Justus38/Laser_galvo_arduino_diy/README.md

# Laser_galvo_arduino_diy
In this project iam using arduino or similar microcontroller to control a laser galvo. Not a stepper motor laser galvo instead a real galvo with real galvo motors
