Justus38/Laser_galvo_arduino_diy/Testing/PCB/files/+-10v dac.kicad_pcb

## KiCad design Testing/PCB/files/+-10v dac.kicad_pcb (2024-12-08)

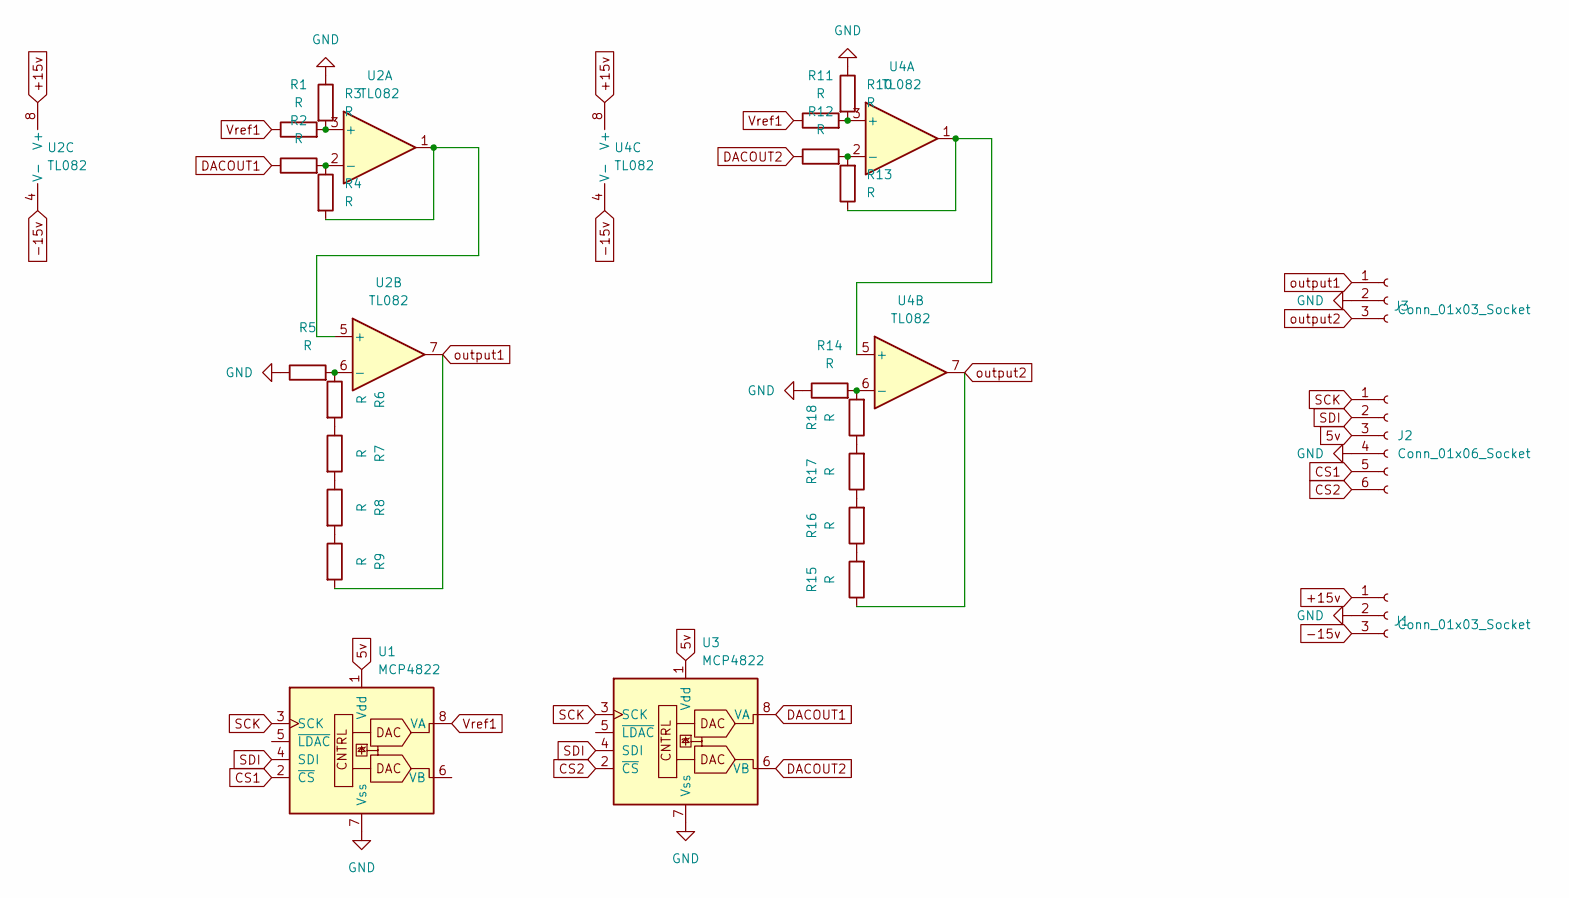
[picture p3: schematic +-10v dac.kicad_sch]

Parts:
J1, J3: Conn_01x03_Socket; PinHeader_1x03_P2.54mm_Vertical
J2: Conn_01x06_Socket; PinHeader_1x06_P2.54mm_Vertical
R1, R2, R3, R4, R5, R6, R7, R8, R9, R10, R11, R12, R13, R14, R15, R16, R17, R18: R; R_1206_3216Metric_Pad1.30x1.75mm_HandSolder
U1, U3: MCP4822; DIP-8_W7.62mm
U2: TL082
U4: TL082; DIP-8_W7.62mm

Connections:
5v: J2.3, U1.1 (Vdd), U3.1 (Vdd)
+15v: J1.1, U2.8 (V+), U4.8 (V+)
-15v: J1.3, U2.4 (V-), U4.4 (V-)
CS1: J2.5, U1.2 (~CS)
CS2: J2.6, U3.2 (~CS)
DACOUT1: R2.1, U3.8 (VA)
DACOUT2: R12.1, U3.6 (VB)
GND: J1.2, J2.4, J3.2, R3.1, R5.1, R10.1, R14.1, U1.7 (Vss), U3.7 (Vss)
unnamed: R6.2, R7.1
unnamed: R7.2, R8.1
unnamed: R8.2, R9.1
unnamed: R15.2, R16.1
unnamed: R16.2, R17.1
unnamed: R17.2, R18.1
unnamed: R1.2, R3.2, U2.3 (+)
unnamed: R2.2, R4.1, U2.2 (-)
unnamed: R4.2, U2.1, U2.5 (+)
unnamed: R5.2, R6.1, U2.6 (-)
unnamed: R10.2, R11.2, U4.3 (+)
unnamed: R12.2, R13.2, U4.2 (-)
unnamed: R13.1, U4.1, U4.5 (+)
unnamed: R14.2, R18.2, U4.6 (-)
SCK: J2.1, U1.3 (SCK), U3.3 (SCK)
SDI: J2.2, U1.4 (SDI), U3.4 (SDI)
Vref1: R1.1, R11.1, U1.8 (VA)
output1: J3.1, R9.2, U2.7
output2: J3.3, R15.1, U4.7

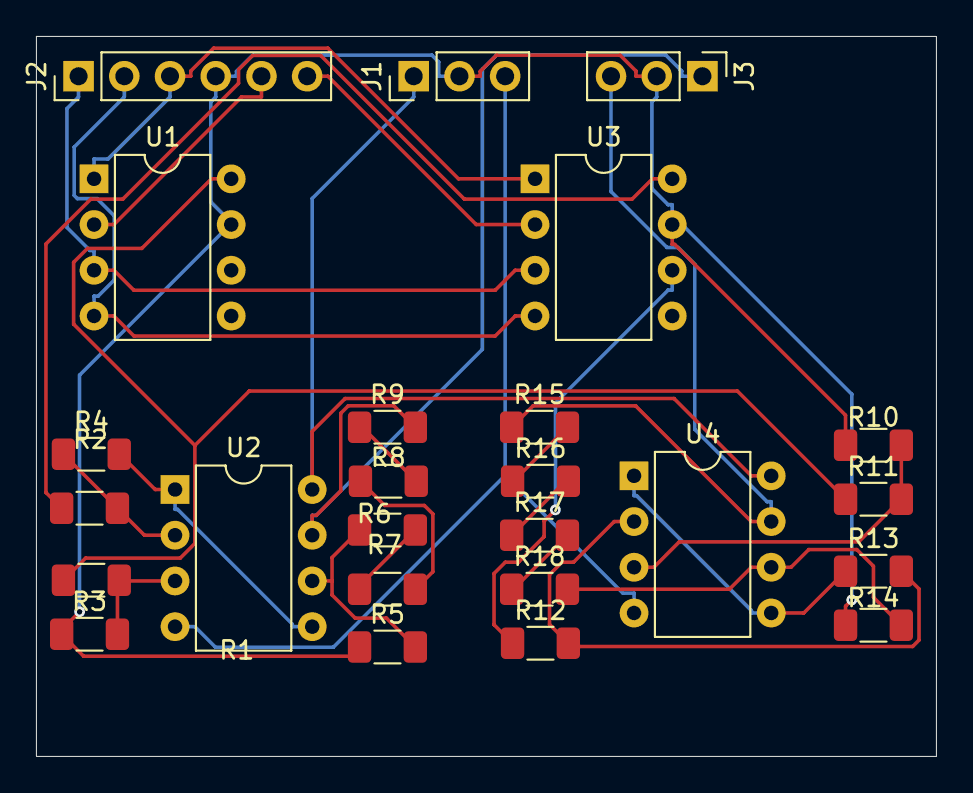
[picture p4: board +-10v dac.kicad_pcb from above]

Board: 2 copper layers, 50.0 x 40.0 mm, 25 parts (0 on the bottom side), 27 nets.
