Justus38/Laser_galvo_arduino_diy/Testing/PCB/README.md

this pcb is just for testing purposes 


i forgot one gnd on the first revision that is why there is the small green wire
