Justus38/Laser_galvo_arduino_diy/Testing/Pictures/20241123_112423.jpg

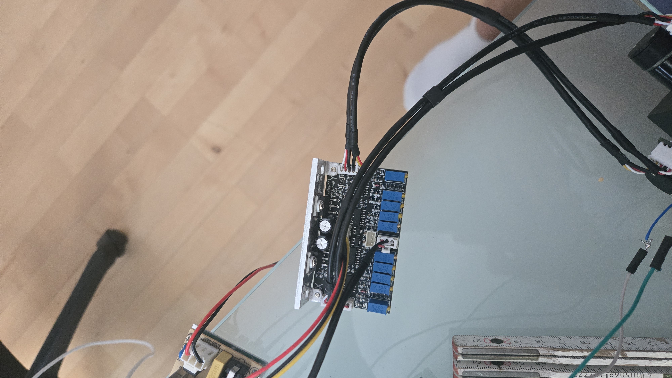
Testing/Pictures/20241123_112423.jpg
