Justus38/Laser_galvo_arduino_diy/programming/Display ARDUINO/textfunk.ino

void setPos(int xc,int yc){
  dac.setVoltageA(2000);
  dac.updateDAC();
  dac1.setVoltageA(map(yc,0,1000,minx,maxx));
  dac1.setVoltageB(map(xc,0,1000,miny,maxy));
  dac1.updateDAC();
}
void E(int startpunktx,int startpunkty){
   
   setPos(startpunktx,startpunkty);
   delay(1);
   digitalWrite(8, HIGH);
   delay(1);
   setPos(startpunktx+100,startpunkty);
   delay(1);
   setPos(startpunktx+100,startpunkty+100);
   delay(1);
   setPos(startpunktx,startpunkty+100);
   delay(1);
   setPos(startpunktx+100,startpunkty+100);
   delay(1);
   setPos(startpunktx+100,startpunkty+200);
   delay(1);
   setPos(startpunktx,startpunkty+200);
   delay(1);
   
   digitalWrite(8, LOW);
   delay(1);
}
void A(int startpunktx,int startpunkty){
  
  setPos(startpunktx, startpunkty);  
  delay(1);
  digitalWrite(8, HIGH);
  delay(1);
  setPos(startpunktx, startpunkty + 200);  

  delay(1);
  setPos(startpunktx + 100, startpunkty+200);  
  delay(1);
  setPos(startpunktx + 100, startpunkty); 

  delay(1);
  setPos(startpunktx + 100, startpunkty + 100);  
  delay(1);
  setPos(startpunktx, startpunkty + 100);  
  delay(1);
  
  digitalWrite(8, LOW);
  delay(1);
}
void B(int startpunktx, int startpunkty){
  setPos(startpunktx, startpunkty);  
  delay(1);
  digitalWrite(8, HIGH);
  delay(1);
  setPos(startpunktx+100, startpunkty);  
  delay(1);
  setPos(startpunktx+100, startpunkty+200);  
  delay(1);
  setPos(startpunktx+40, startpunkty+200);  
  delay(1);
  setPos(startpunktx+40, startpunkty+100);  
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
  delay(1);
  setPos(startpunktx+50, startpunkty);  
  delay(1);
  setPos(startpunktx+50, startpunkty+200);  
  delay(1);
  setPos(startpunktx+25, startpunkty+200);  
  delay(1);
  setPos(startpunktx+75, startpunkty+200);  
  delay(1);
  digitalWrite(8,LOW);
  delay(1);
}
